akpc806a/CAN_Bridge/(list of files, cad)

Other CAD files:
3d/can_bridge.skp
