akpc806a/CAN_Bridge/(threads)

Thread 1 (2020-09-10):

Compiled binary?

normaldotcom, 2020-09-10:
Hello! Do you happen to have a compiled binary of the firmware? I do not have the proprietary Keil toolchain to build. Thanks!

akpc806a, 2020-09-10:
Hi, you can try this HEX
https://sites.google.com/site/akpc806a/STM32F1_can.hex

serg0374, 2020-09-24:
Hi Alex. What chip is your can bridge built on? The description on the website www.tindie.com indicates the STM32F105R8T6 microcontroller, the diagram indicates STM32F072RBT6, the board indicates STM32F405XX. I want to repeat your project, but I don't understand which microcontroller is needed.

tusker-tools, 2022-08-07:
> Hi, you can try this HEX
> https://sites.google.com/site/akpc806a/STM32F1_can.hex

Hi Alex. It would be much more intuitive to find the compiled binary as release in the GitHub project main page (might save time for people to search). It would be great if you could upload it. Thanks!

deepalarm, 2025-02-23:
Hi alex, give pls binary for your great device

deepalarm, 2025-02-26:
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

deepalarm, 2025-03-30:
can you tell in what programm you built project ?
if it was cube ide

Could you please add the .ioc file to GitHub.

akpc806a, 2025-03-31:
I just pushed https://github.com/akpc806a/CAN_Bridge/tree/master/Firmware
It is incomplete IOC, there are no LEDs.
The project is in Keil 5, freeware version may work (with code size limit).
Also node if you are going to use this board permanently in a vehicle --
you need to add resettable fuse and TVS diode to protect against voltage
surges. Otherwise it eventually going to die.

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

deepalarm, 2025-04-10:
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

I prepared the boards according to your project, but it is strange that there is a short circuit on the ground and VCC lines.

I also saw on your site that you made a tester on the f405 chip, there were no changes in the lines? If you use f405?!

akpc806a, 2025-04-10:
You need to use F105
The F405 is not compatible

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

deepalarm, 2025-04-28:
> You need to use F105
> The F405 is not compatible
> […](#)

i ve made pcb with f105
but there is short circut on tle + and - line in yor project

Thread 2 (2022-08-07):

Provide CubeMX project (.ioc) file

tusker-tools, 2022-08-07:
Hi Alex,
thanks for this nice and useful project. I appreciate especially the good documentation!

Currently I'm considering to use this project with a similar PCB, which can inexpensively be purchased in known chinese warehouses. It is described for example in this project: [Canfilter](https://github.com/EliasKotlyar/Canfilter)

The pin configuration for that HW is slightly differing to the one used in your project.
Your base code seems to be auto-generated with STM CubeMX, but unfortunately I can't find the related .ioc file. This would make it a lot easier for me to change your code to match the "China" PCB.

Could you please add the .ioc file to GitHub.

Thanks a lot!
