akpc806a/CAN_Bridge/Hardware/CAN_Bridge.pdf

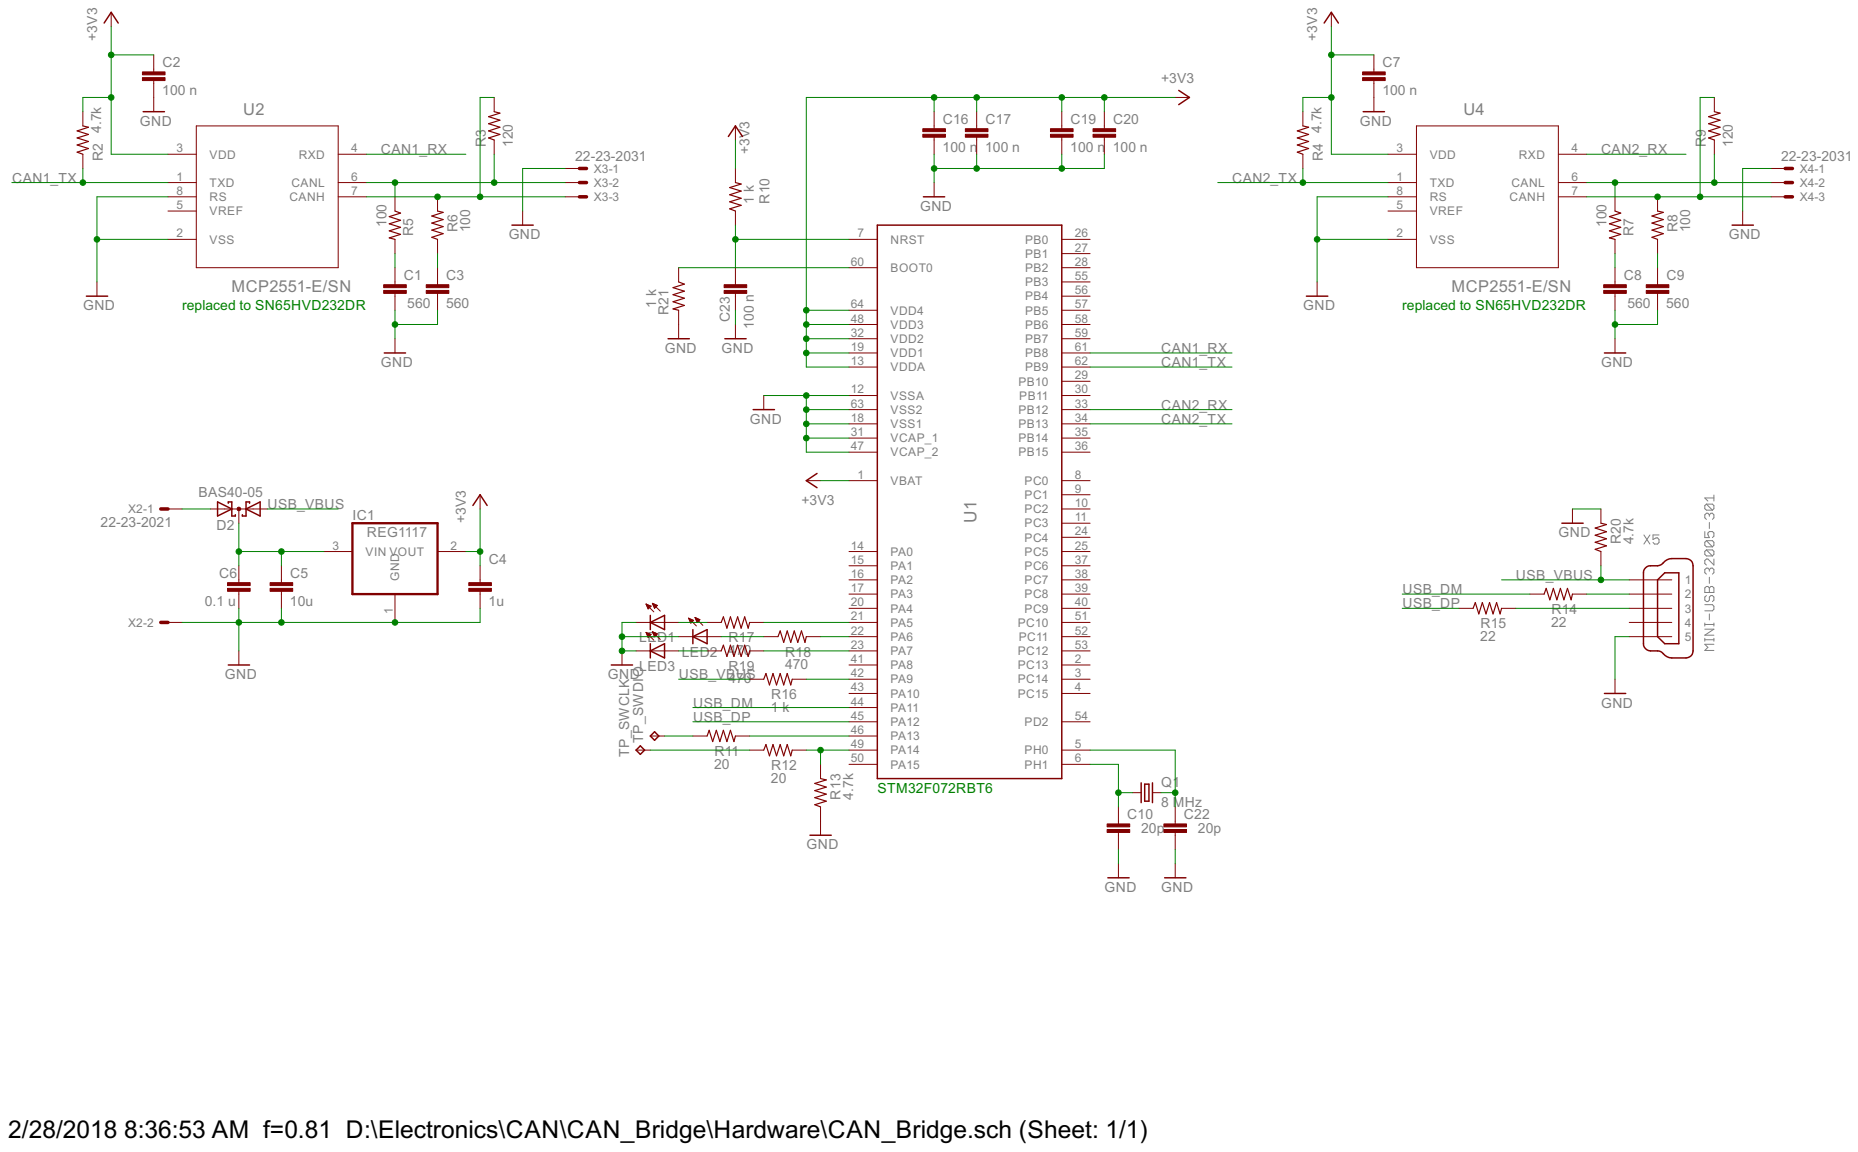
[picture p12: page 1]

2/28/2018 8:36:53 AM f=0.81 D:\Electronics\CAN\CAN_Bridge\Hardware\CAN_Bridge.sch (Sheet: 1/1)
