akpc806a/CAN_Bridge/Hardware/CAN_Bridge.brd

## EAGLE design Hardware/CAN_Bridge.brd (2018-02-28)

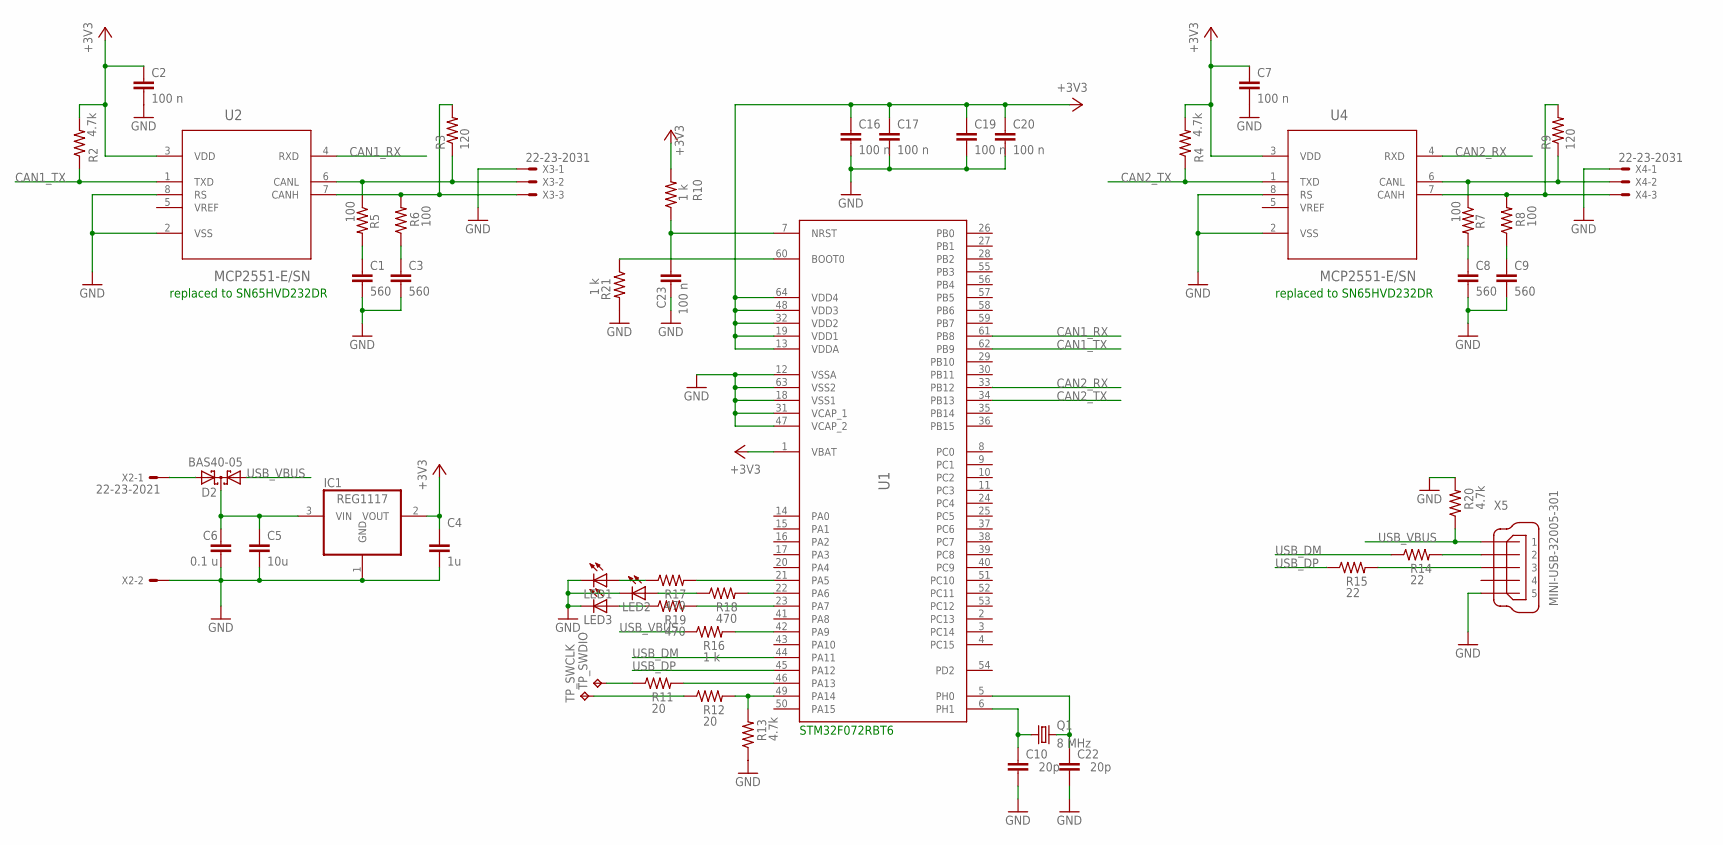
[picture p13: schematic CAN_Bridge.sch]

Parts:
C1, C3, C8, C9: 560; C0603
C2, C7, C16, C17, C19, C20, C23: 100 n; C0603
C4: 1u; C0603
C5: 10u; C1206
C6: 0.1 u; C0603
C10, C22: 20p; C0603
D2: BAS40-05; SOT23
IC1: REG1117; SOT223
LED1, LED2, LED3: LED_ESML0603; LED_SML0603
Q1: 8 MHz; SM49
R2, R4, R13, R20: 4.7k; R0603
R3, R9: 120; R0805
R5, R6, R7, R8: 100; R0603
R10, R16, R21: 1 k; R0603
R11, R12: 20; R0603
R14, R15: 22; R0603
R17, R18, R19: 470; R0603
TP_SWCLK: TPTP10SQ; TP10SQ
TP_SWDIO: TPTP10SQ; TP10SQ
U1: STM32F405XXSTM32F405XX; LQFP64
U2, U4: MCP2551-E/SN; SOIC127P600X175-8N
X2: 22-23-2021
X3, X4: 22-23-2031
X5: MINI-USB-32005-301; 32005-301

Connections:
+3V3: C2.1, C4.1, C7.1, C16.1, C17.1, C19.1, C20.1, IC1.2 (VOUT), R2.2, R4.2, R10.2, U1.1 (VBAT), U1.13 (VDDA), U1.19 (VDD1), U1.32 (VDD2), U1.48 (VDD3), U1.64 (VDD4), U2.3 (VDD), U4.3 (VDD)
CAN1_RX: U1.61 (PB8), U2.4 (RXD)
CAN1_TX: R2.1, U1.62 (PB9), U2.1 (TXD)
CAN2_RX: U1.33 (PB12), U4.4 (RXD)
CAN2_TX: R4.1, U1.34 (PB13), U4.1 (TXD)
GND: C1.2, C2.2, C3.2, C4.2, C5.2, C6.2, C7.2, C8.2, C9.2, C10.2, C16.2, C17.2, C19.2, C20.2, C22.2, C23.2, IC1.1 (GND), LED1.C, LED2.C, LED3.C, R13.1, R20.2, R21.2, U1.12 (VSSA), U1.18 (VSS1), U1.31 (VCAP_1), U1.47 (VCAP_2), U1.63 (VSS2), U2.2 (VSS), U2.8 (RS), U4.2 (VSS), U4.8 (RS), X2.2, X3.1, X4.1, X5.5
unnamed: R3.1, R5.1, U2.6 (CANL), X3.2
unnamed: R3.2, R6.2, U2.7 (CANH), X3.3
unnamed: C1.1, R5.2
unnamed: C3.1, R6.1
unnamed: R17.2, U1.21 (PA5)
unnamed: R7.1, R9.1, U4.6 (CANL), X4.2
unnamed: C5.1, C6.1, D2.3 (C), IC1.3 (VIN)
unnamed: R8.2, R9.2, U4.7 (CANH), X4.3
unnamed: C8.1, R7.2
unnamed: C9.1, R8.1
unnamed: R18.2, U1.22 (PA6)
unnamed: R19.2, U1.23 (PA7)
unnamed: LED1.A, R17.1
unnamed: LED2.A, R18.1
unnamed: LED3.A, R19.1
unnamed: R11.2, U1.46 (PA13)
unnamed: R12.2, R13.2, U1.49 (PA14)
unnamed: R11.1, TP_SWDIO.TP
unnamed: R12.1, TP_SWCLK.TP
unnamed: C23.1, R10.1, U1.7 (NRST)
unnamed: R21.1, U1.60 (BOOT0)
unnamed: D2.2 (A2), X2.1
unnamed: R16.2, U1.42 (PA9)
unnamed: R15.2, X5.3
unnamed: C22.1, Q1.2, U1.5 (PH0)
unnamed: C10.1, Q1.1, U1.6 (PH1)
unnamed: R14.2, X5.2
USB_DM: R14.1, U1.44 (PA11)
USB_DP: R15.1, U1.45 (PA12)
USB_VBUS: D2.1 (A1), R16.1, R20.1, X5.1

Notes on the sheet:
replaced to SN65HVD232DR
STM32F072RBT6

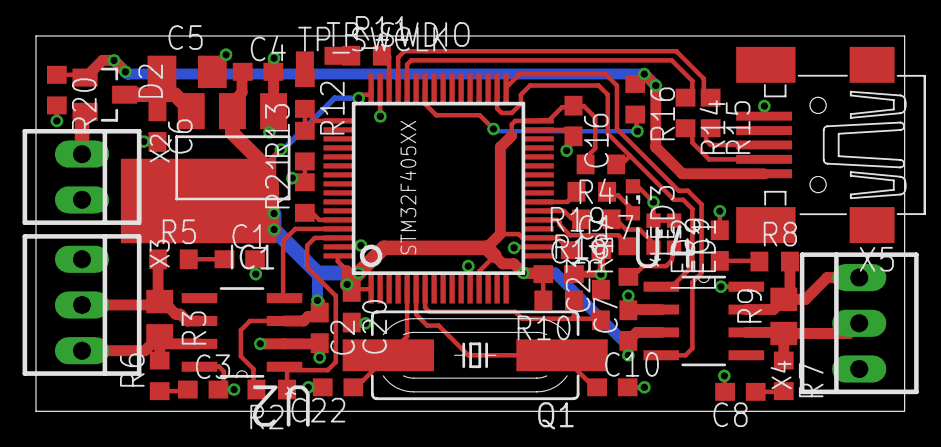
[picture p14: board CAN_Bridge.brd from above]

Board: 2 copper layers, 48.3 x 20.8 mm, 51 parts (0 on the bottom side), 36 nets.
