akpc806a/CAN_Bridge/Firmware/STM32F1_can.ioc

Mcu.UserName=STM32F105RBTx
PA11.Signal=USB_OTG_FS_DM
PA12.Signal=USB_OTG_FS_DP
PB12.Signal=CAN2_RX
PB13.Signal=CAN2_TX
PB8.Signal=CAN1_RX
PB9.Signal=CAN1_TX
PD0-OSC_IN.Signal=RCC_OSC_IN
PD1-OSC_OUT.Signal=RCC_OSC_OUT
