akpc806a/CAN_Bridge/Software/CANConfigureTool.cpp

//---------------------------------------------------------------------------

#include <vcl.h>
#pragma hdrstop
//---------------------------------------------------------------------------
USEFORM("Main.cpp", MainForm);
//---------------------------------------------------------------------------
WINAPI WinMain(HINSTANCE, HINSTANCE, LPSTR, int)
{
        try
        {
                 Application->Initialize();
                 Application->CreateForm(__classid(TMainForm), &MainForm);
                 Application->Run();
        }
        catch (Exception &exception)
        {
                 Application->ShowException(&exception);
        }
        catch (...)
        {
                 try
                 {
                         throw Exception("");
                 }
                 catch (Exception &exception)
                 {
                         Application->ShowException(&exception);
                 }
        }
        return 0;
}
//---------------------------------------------------------------------------
