akpc806a/CAN_Bridge/(commit log)

2016-08-08 Initial release, get ready for the Tindie
    [CAN_Bridge.brd, CAN_Bridge.sch]
2017-10-03 3d model added
    3d design provided by Dott. Ing. Dario Armellin
    [can_bridge.skp]
2018-02-28 new revision of hardware (minor changes)
    [CAN_Bridge.brd, CAN_Bridge.sch]
